dh219/68k_cpld_devboard/README.md

# 68k_cpld_devboard

A CPLD devboard for the DIP64 68000.
