dh219/68k_cpld_devboard/68k_cpld_devboard.kicad_pcb

## KiCad design 68k_cpld_devboard.kicad_pcb (2024-09-12)

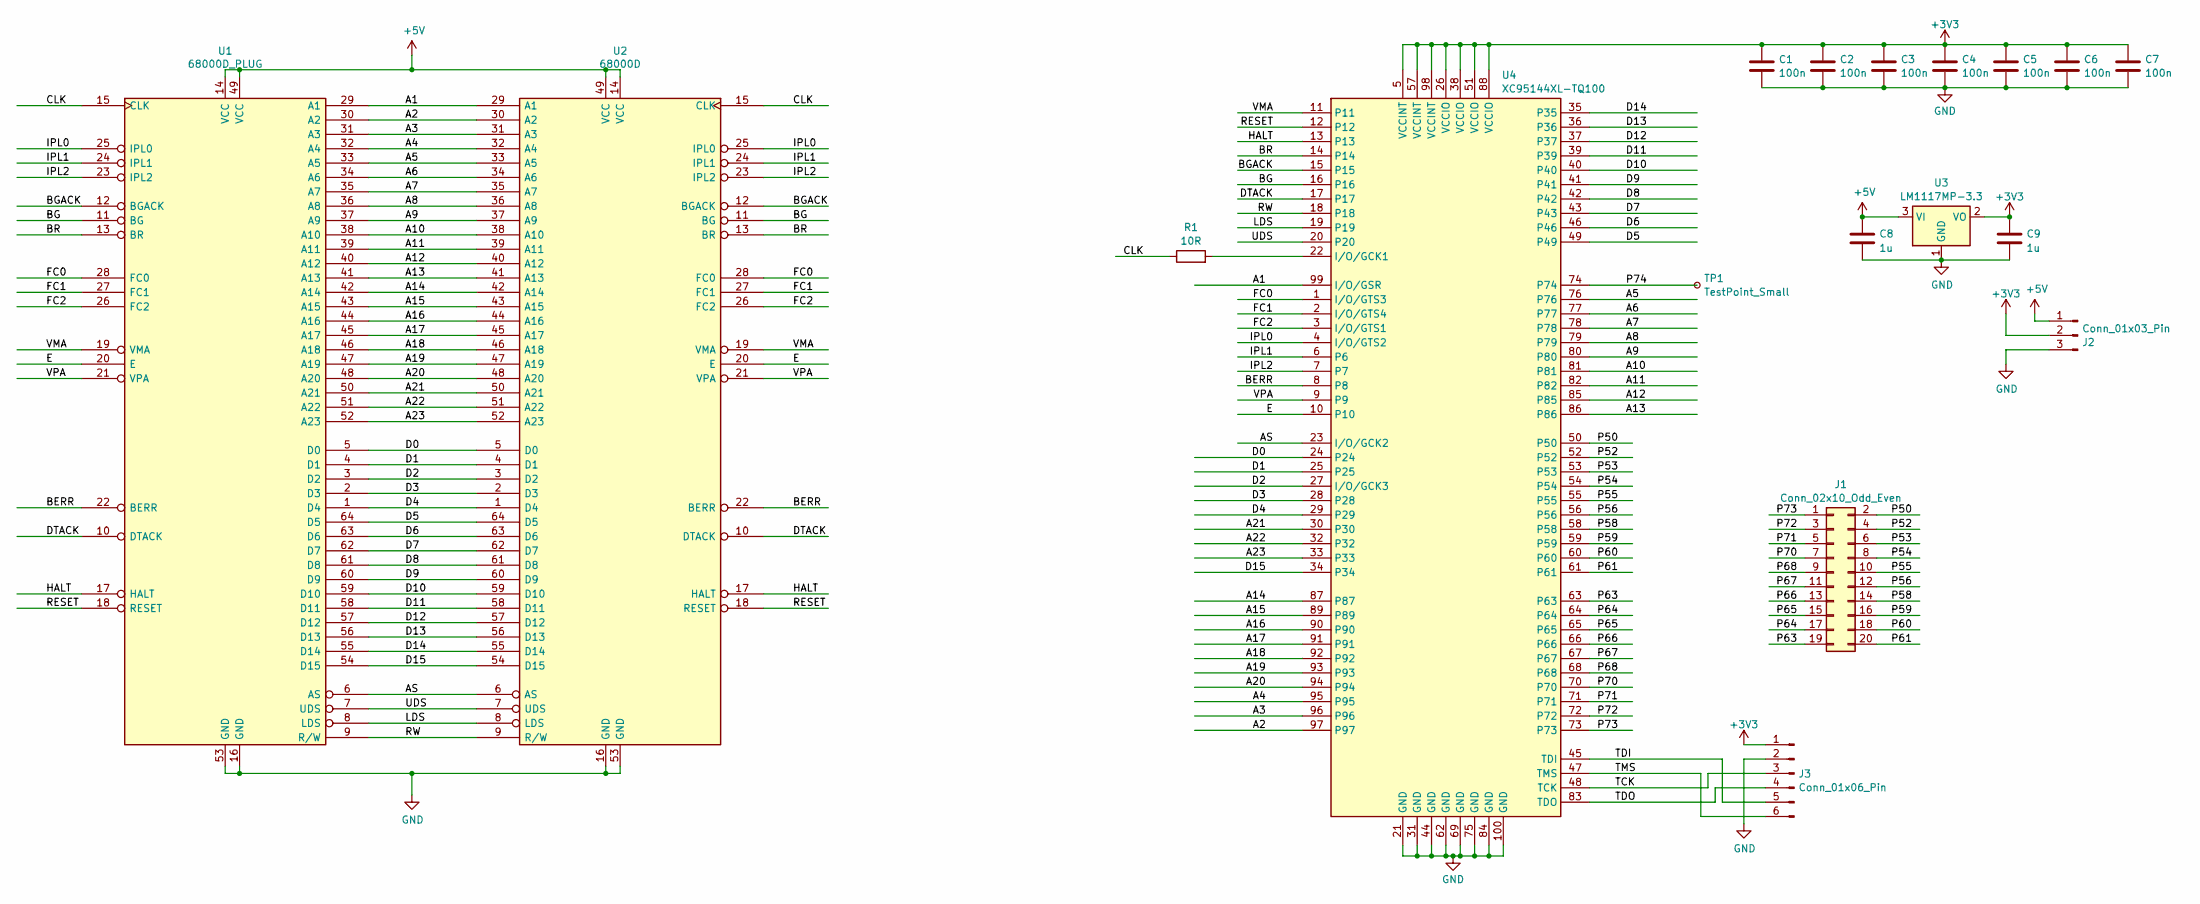
[picture p1: schematic 68k_cpld_devboard.kicad_sch, 68K CPLD Devboard]

Parts:
C1, C2, C3, C4, C5, C6, C7: 100n; C_0805_2012Metric_Pad1.18x1.45mm_HandSolder
C8, C9: 1u; C_0805_2012Metric_Pad1.18x1.45mm_HandSolder
J1: Conn_02x10_Odd_Even; PinSocket_2x10_P2.54mm_Vertical
J2: Conn_01x03_Pin; PinHeader_1x03_P2.54mm_Vertical
J3: Conn_01x06_Pin; PinHeader_1x06_P2.54mm_Vertical
R1: 10R; R_0805_2012Metric_Pad1.20x1.40mm_HandSolder
TP1: TestPoint_Small; TestPoint_Pad_D1.0mm
U1: 68000D_PLUG; DIP-64_W22.86mm_LongPads
U2: 68000D; DIP-64_W22.86mm_Socket_LongPads
U3: LM1117MP-3.3; SOT-223-3_TabPin2
U4: XC95144XL-TQ100; TQFP-100_14x14mm_P0.5mm

Connections:
+3V3: C1.1, C2.1, C3.1, C4.1, C5.1, C6.1, C7.1, C9.1, J2.2, J3.1, U3.2 (VO), U4.5 (VCCINT), U4.26 (VCCIO), U4.38 (VCCIO), U4.51 (VCCIO), U4.57 (VCCINT), U4.88 (VCCIO), U4.98 (VCCINT)
+5V: C8.1, J2.1, U1.14 (VCC), U1.49 (VCC), U2.14 (VCC), U2.49 (VCC), U3.3 (VI)
/A1: U1.29 (A1), U2.29 (A1), U4.99 (I/O/GSR)
/A2: U1.30 (A2), U2.30 (A2), U4.97
/A3: U1.31 (A3), U2.31 (A3), U4.96
/A4: U1.32 (A4), U2.32 (A4), U4.95
/A5: U1.33 (A5), U2.33 (A5), U4.76
/A6: U1.34 (A6), U2.34 (A6), U4.77
/A7: U1.35 (A7), U2.35 (A7), U4.78
/A8: U1.36 (A8), U2.36 (A8), U4.79
/A9: U1.37 (A9), U2.37 (A9), U4.80
/A10: U1.38 (A10), U2.38 (A10), U4.81
/A11: U1.39 (A11), U2.39 (A11), U4.82
/A12: U1.40 (A12), U2.40 (A12), U4.85
/A13: U1.41 (A13), U2.41 (A13), U4.86
/A14: U1.42 (A14), U2.42 (A14), U4.87
/A15: U1.43 (A15), U2.43 (A15), U4.89
/A16: U1.44 (A16), U2.44 (A16), U4.90
/A17: U1.45 (A17), U2.45 (A17), U4.91
/A18: U1.46 (A18), U2.46 (A18), U4.92
/A19: U1.47 (A19), U2.47 (A19), U4.93
/A20: U1.48 (A20), U2.48 (A20), U4.94
/A21: U1.50 (A21), U2.50 (A21), U4.30
/A22: U1.51 (A22), U2.51 (A22), U4.32
/A23: U1.52 (A23), U2.52 (A23), U4.33
/AS: U1.6 (AS), U2.6 (AS), U4.23 (I/O/GCK2)
/BERR: U1.22 (BERR), U2.22 (BERR), U4.8
/BG: U1.11 (BG), U2.11 (BG), U4.16
/BGACK: U1.12 (BGACK), U2.12 (BGACK), U4.15
/BR: U1.13 (BR), U2.13 (BR), U4.14
/CLK: R1.1, U1.15 (CLK), U2.15 (CLK)
/D0: U1.5 (D0), U2.5 (D0), U4.24
/D1: U1.4 (D1), U2.4 (D1), U4.25
/D2: U1.3 (D2), U2.3 (D2), U4.27 (I/O/GCK3)
/D3: U1.2 (D3), U2.2 (D3), U4.28
/D4: U1.1 (D4), U2.1 (D4), U4.29
/D5: U1.64 (D5), U2.64 (D5), U4.49
/D6: U1.63 (D6), U2.63 (D6), U4.46
/D7: U1.62 (D7), U2.62 (D7), U4.43
/D8: U1.61 (D8), U2.61 (D8), U4.42
/D9: U1.60 (D9), U2.60 (D9), U4.41
/D10: U1.59 (D10), U2.59 (D10), U4.40
/D11: U1.58 (D11), U2.58 (D11), U4.39
/D12: U1.57 (D12), U2.57 (D12), U4.37
/D13: U1.56 (D13), U2.56 (D13), U4.36
/D14: U1.55 (D14), U2.55 (D14), U4.35
/D15: U1.54 (D15), U2.54 (D15), U4.34
/DTACK: U1.10 (DTACK), U2.10 (DTACK), U4.17
/E: U1.20 (E), U2.20 (E), U4.10
/FC0: U1.28 (FC0), U2.28 (FC0), U4.1 (I/O/GTS3)
/FC1: U1.27 (FC1), U2.27 (FC1), U4.2 (I/O/GTS4)
/FC2: U1.26 (FC2), U2.26 (FC2), U4.3 (I/O/GTS1)
/HALT: U1.17 (HALT), U2.17 (HALT), U4.13
/IPL0: U1.25 (IPL0), U2.25 (IPL0), U4.4 (I/O/GTS2)
/IPL1: U1.24 (IPL1), U2.24 (IPL1), U4.6
/IPL2: U1.23 (IPL2), U2.23 (IPL2), U4.7
/LDS: U1.8 (LDS), U2.8 (LDS), U4.19
/P50: J1.2, U4.50
/P52: J1.4, U4.52
/P53: J1.6, U4.53
/P54: J1.8, U4.54
/P55: J1.10, U4.55
/P56: J1.12, U4.56
/P58: J1.14, U4.58
/P59: J1.16, U4.59
/P60: J1.18, U4.60
/P61: J1.20, U4.61
/P63: J1.19, U4.63
/P64: J1.17, U4.64
/P65: J1.15, U4.65
/P66: J1.13, U4.66
/P67: J1.11, U4.67
/P68: J1.9, U4.68
/P70: J1.7, U4.70
/P71: J1.5, U4.71
/P72: J1.3, U4.72
/P73: J1.1, U4.73
/P74: TP1.1, U4.74
/RESET: U1.18 (RESET), U2.18 (RESET), U4.12
/RW: U1.9 (R/W), U2.9 (R/W), U4.18
/TCK: J3.3, U4.48 (TCK)
/TDI: J3.5, U4.45 (TDI)
/TDO: J3.4, U4.83 (TDO)
/TMS: J3.6, U4.47 (TMS)
/UDS: U1.7 (UDS), U2.7 (UDS), U4.20
/VMA: U1.19 (VMA), U2.19 (VMA), U4.11
/VPA: U1.21 (VPA), U2.21 (VPA), U4.9
GND: C1.2, C2.2, C3.2, C4.2, C5.2, C6.2, C7.2, C8.2, C9.2, J2.3, J3.2, U1.16 (GND), U1.53 (GND), U2.16 (GND), U2.53 (GND), U3.1 (GND), U4.21 (GND), U4.31 (GND), U4.44 (GND), U4.62 (GND), U4.69 (GND), U4.75 (GND), U4.84 (GND), U4.100 (GND)
unnamed: R1.2, U4.22 (I/O/GCK1)

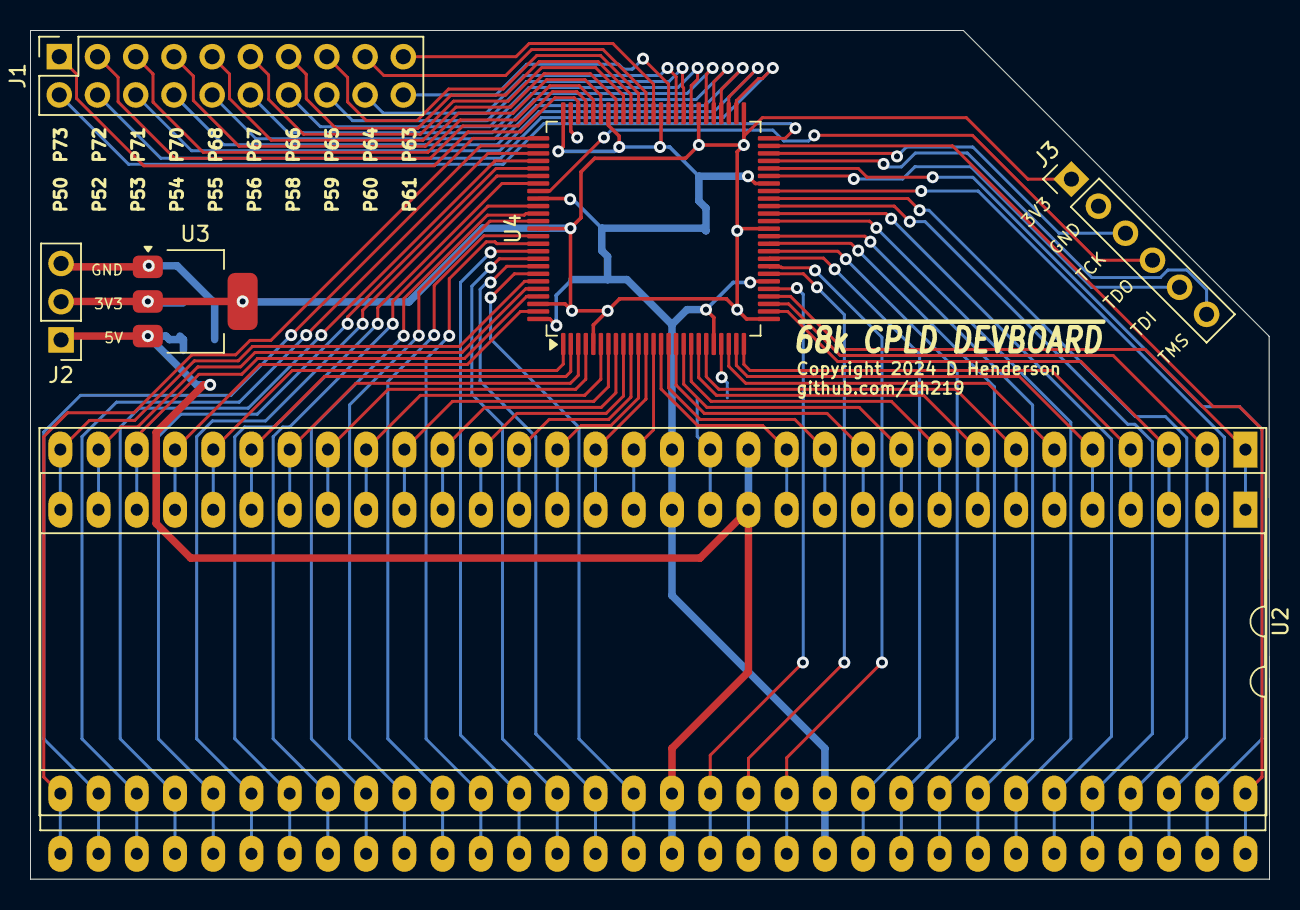
[picture p2: board 68k_cpld_devboard.kicad_pcb from above]

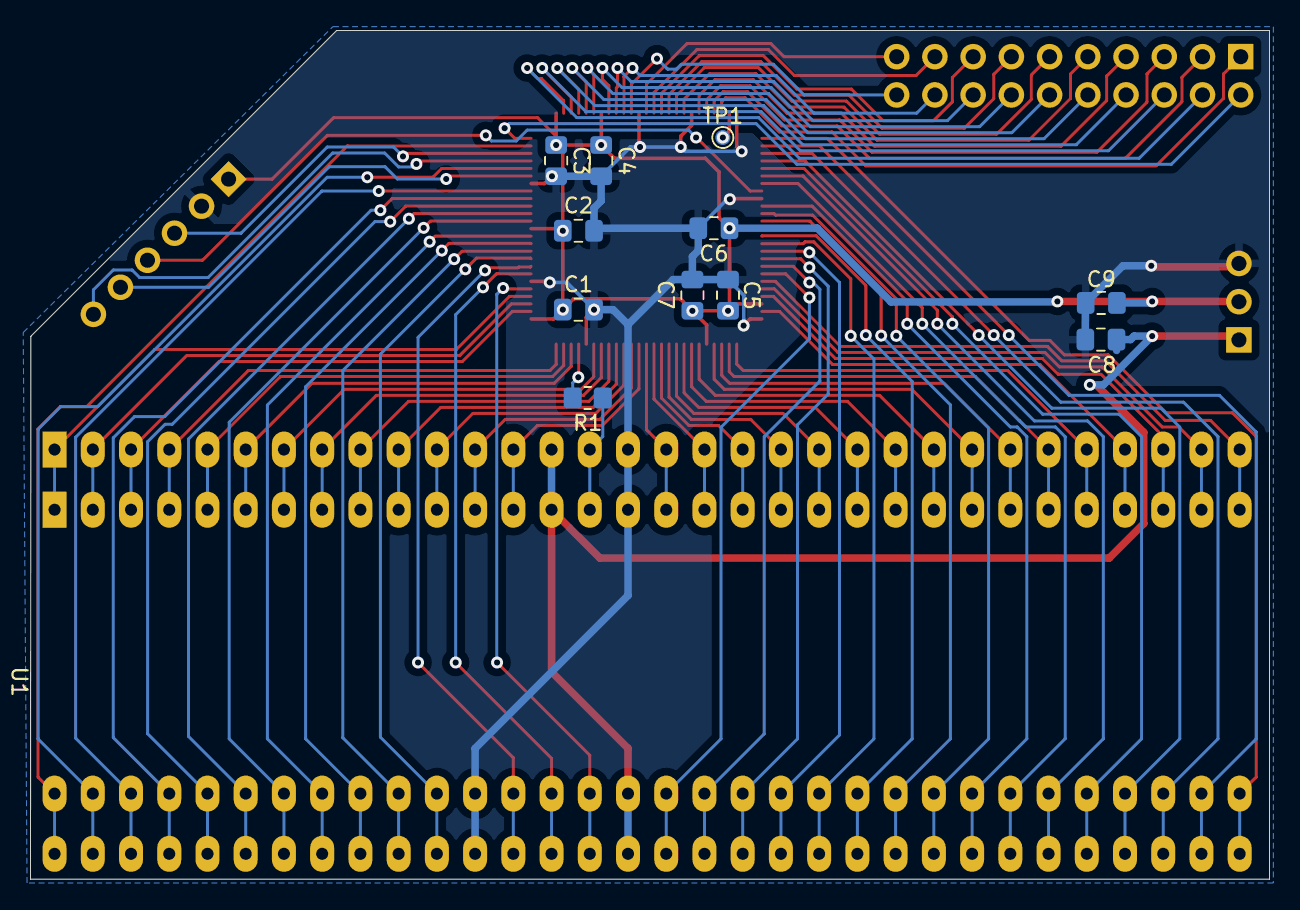
[picture p3: board 68k_cpld_devboard.kicad_pcb from below]

Board: 2 copper layers, 82.3 x 56.4 mm, 18 parts (11 on the bottom side), 89 nets.
