dh219/68k_cpld_devboard/(commit log)

2023-10-26 Initial start of project, copied from 68k_debug
    [68k_breakout_3v3.kicad_pcb, 68k_breakout_3v3.kicad_sch]
2023-10-30 Initial layout complete
    [68k_breakout_3v3.kicad_pcb, 68k_breakout_3v3.kicad_sch]
2023-10-31 Tweaked layout to better fit. Passes DRC
    [68k_breakout_3v3.kicad_pcb]
2023-10-31 Adding copyright
    [68k_breakout_3v3.kicad_pcb]
2023-10-31 Minor tweaks pre-gerberisation
    [68k_breakout_3v3.kicad_pcb, 68k_breakout_3v3.kicad_sch]
2024-09-12 Started conversion of the old project to a CPLD breakout board
    [68k_breakout_3v3.kicad_pcb, 68k_breakout_3v3.kicad_sch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]
2024-09-12 Passing DRC
    [68k_cpld_devboard.kicad_pcb, 68k_cpld_devboard.kicad_sch]
2024-09-12 Rev 1 ordered
    [68k_cpld_devboard.kicad_pcb]
2024-10-03 Starting point Verilog project that simply sets all pins bar TP1 as input. TP1 is driven to ground.
2024-10-08 Experimental LED display demo starting
2024-10-18 Current approach not quick enough. Will experiemtn with some PIO techniques.
2024-10-27 reasonably reliably write sniffing although state machine doesn't need to wait for AS to go high any more.
    [picovid.v]
2024-12-12 Communication now working semi-reliably. Work at software end needed now. See 47a0682c7aac7dd50775228d36c1d17a406593ef on pico playground
2024-12-12 UDS/LDS mistake. Hopefully better now.
    [picovid.v]
2024-12-20 Cleaning up naming of the ds_in register to avoid confusion.
    [picovid.v]
2025-04-26 Initial bringup of proper DDB1 board -- not fully working yet
2025-04-28 Had to use TP4 to qualify accesses to memory because I hadn't realised the shifter was on the 'wrong' side of the memory buffers. Also added mode change reset timer.
    [picovid.v]
2025-09-28 Image stabilised with MMUBoard added and TP4 used for the Vsync, but refresh is poor. Need to work on pico firmware again next.
    [picovid.v]
2025-10-02 After much fighting, write sniffing seems to be almost working again (even blanking again a problem)
    [picovid.v]
2025-10-05 Data capture still not working properly
    [picovid.v]
