dh219/68k_cpld_devboard/(notices)

Notices in the files:
68k_cpld_devboard.kicad_pcb:
Copyright 2024 D Henderson
